akornsys-rdi/simple-inductance-meter/README.md

# Simple Inductance Meter

My implementation of the simple inductance meter designed by Danyk [(http://www.danyk.cz/lmetr_en.html)](http://www.danyk.cz/lmetr_en.html).
