akornsys-rdi/simple-inductance-meter/3d/banana-spacer.stl

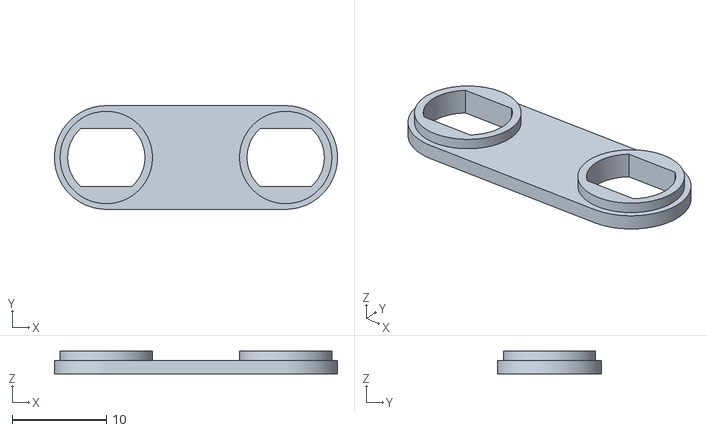
[picture p1: CAD file, 2021-05-23]
3d/banana-spacer.stl
30.1 x 11.0 x 2.40
