akornsys-rdi/simple-inductance-meter/3d/rotary-sw-spacer.stl

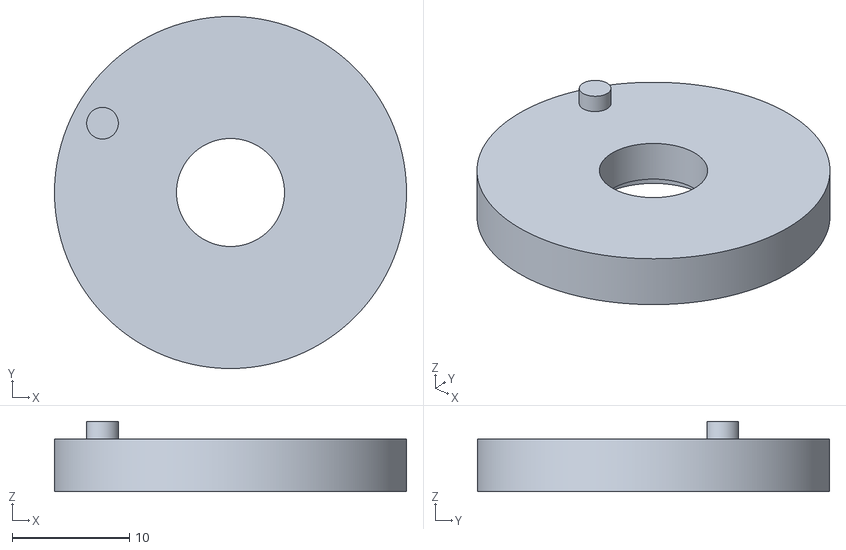
[picture p2: CAD file, 2021-05-23]
3d/rotary-sw-spacer.stl
30.0 x 30.0 x 6.00
