akornsys-rdi/simple-inductance-meter/3d/box.stl

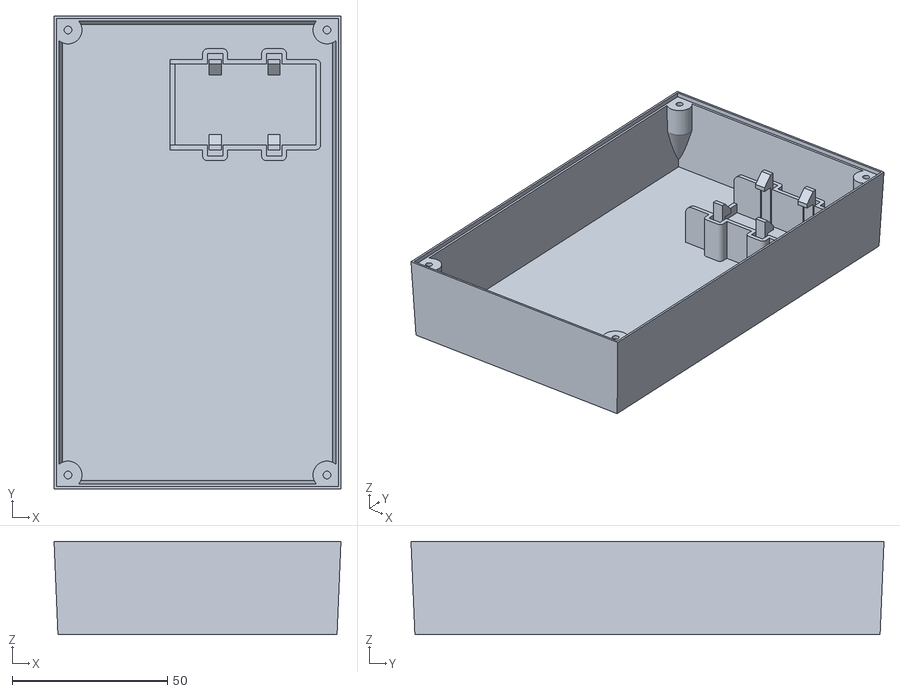
[picture p3: CAD file, 2021-05-23]
3d/box.stl
92.5 x 152.5 x 30.0
