akornsys-rdi/simple-inductance-meter/doc/silkscreen.pdf

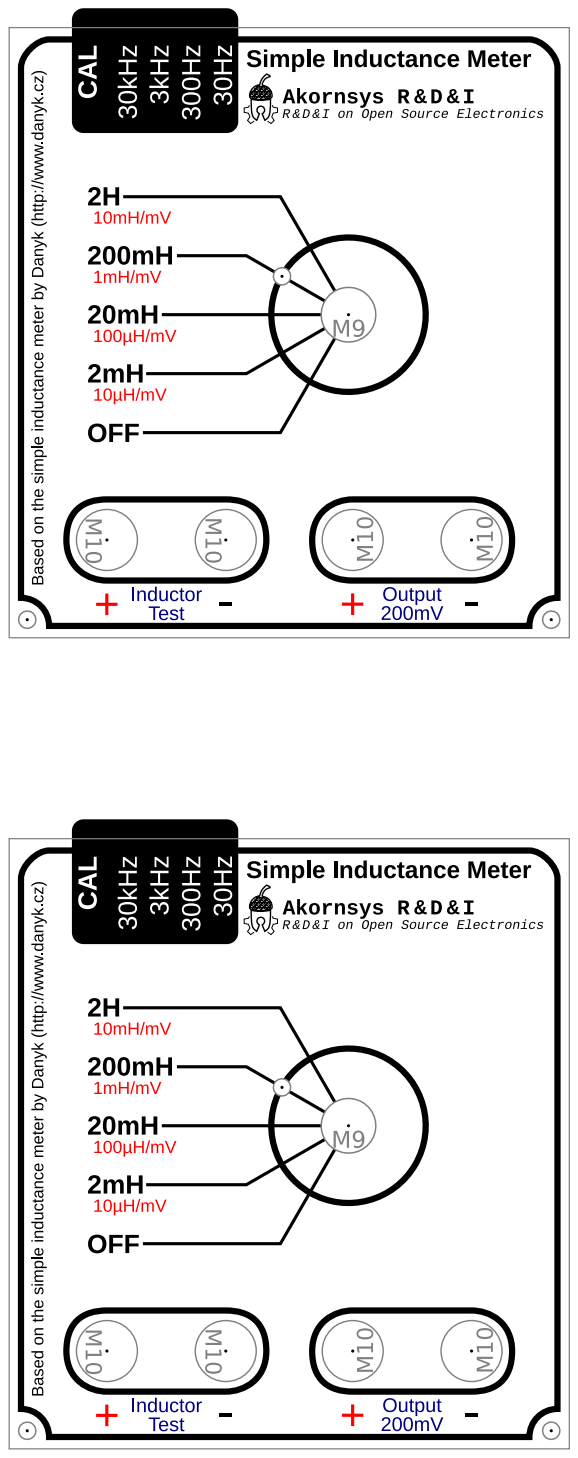
[picture p4: page 1]
