akornsys-rdi/simple-inductance-meter/brd/simple-inductance-meter.kicad_pcb

## KiCad design brd/simple-inductance-meter.kicad_pcb (2021-05-23)

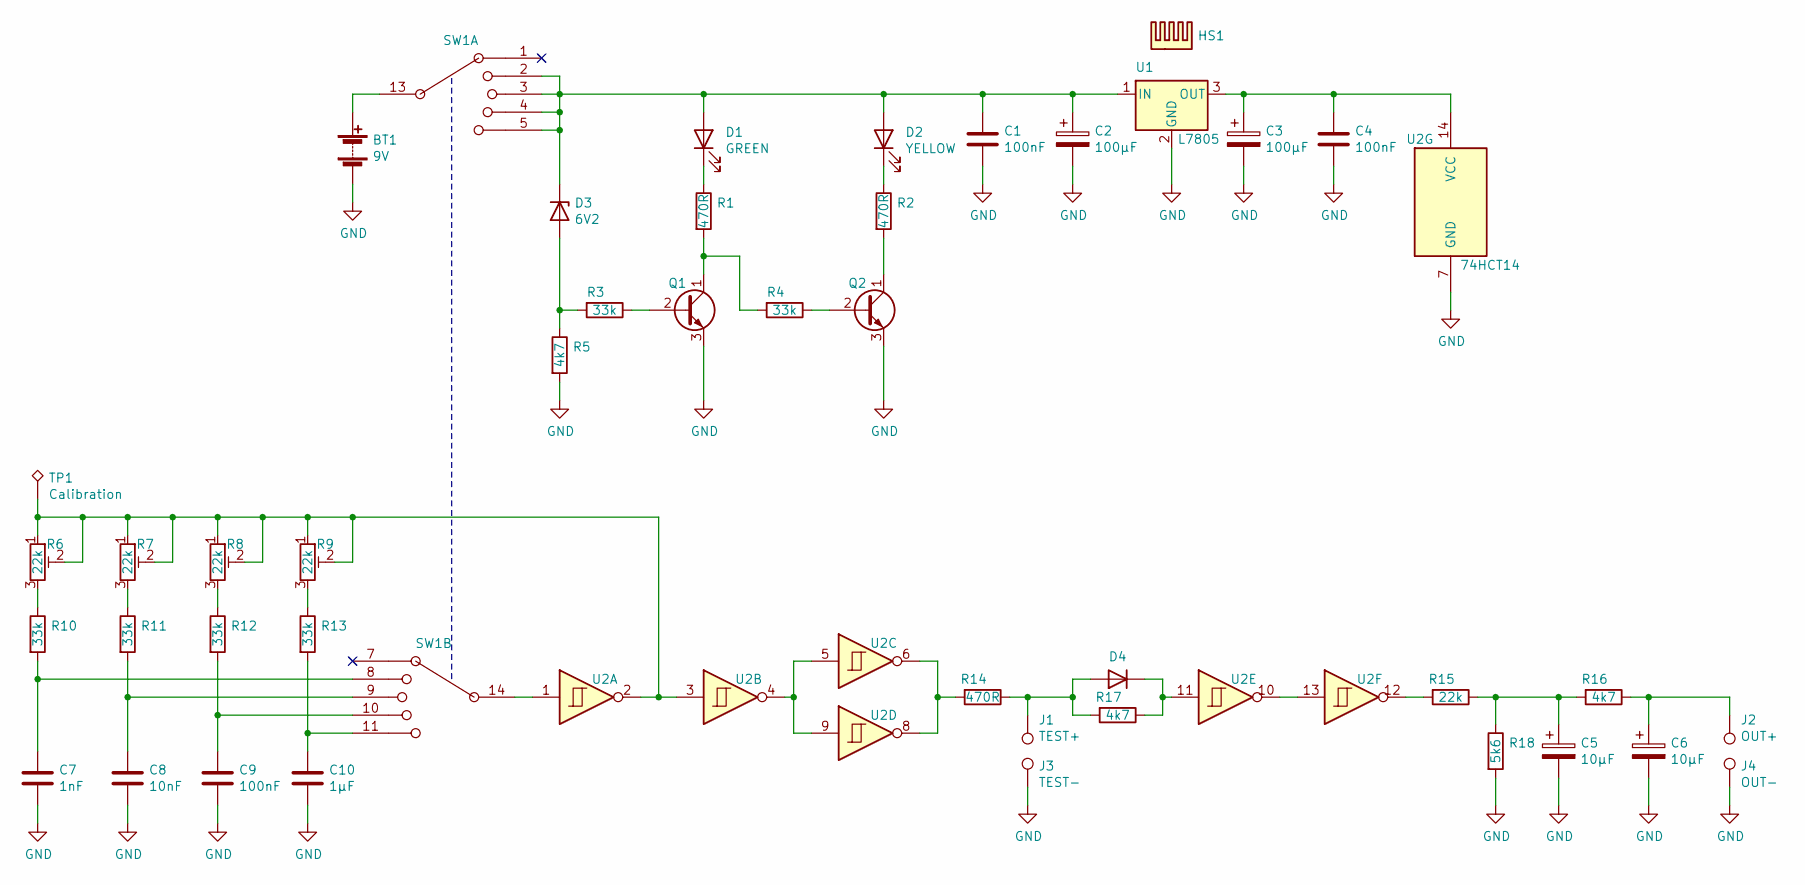
[picture p5: schematic simple-inductance-meter.sch]

Parts:
BT1: 9V; SolderWire-0.5sqmm_1x02_P4.6mm_D0.9mm_OD2.1mm; Manufacturer Part Number 233
C1, C4, C9: 100nF; C_Disc_D4.7mm_W2.5mm_P5.00mm; Manufacturer Part Number K104K15X7RF53H5
C2, C3: 100µF; CP_Radial_D6.3mm_P2.50mm; Manufacturer Part Number 860010473007
C5, C6: 10µF; CP_Radial_Tantal_D5.0mm_P5.00mm; Manufacturer Part Number TAP106K016CRW
C7: 1nF; C_Disc_D4.7mm_W2.5mm_P5.00mm; Manufacturer Part Number K102K15X7RH5UH5
C8: 10nF; C_Disc_D4.7mm_W2.5mm_P5.00mm; Manufacturer Part Number 1C20X7R103K100B
C10: 1µF; C_Disc_D4.7mm_W2.5mm_P5.00mm; Manufacturer Part Number FG28X5R1H105KRT00
D1: GREEN; LED_D5.0mm; Manufacturer Part Number LTL-4233
D2: YELLOW; LED_D5.0mm; Manufacturer Part Number LTL-4273
D3: 6V2; D_DO-41_SOD81_P10.16mm_Horizontal; Manufacturer Part Number BZX85C6V2-TAP
D4: 1N4148; D_DO-35_SOD27_P7.62mm_Horizontal; Manufacturer Part Number 1N4148TR
HS1: TO220 Heatsink; Heatsink_Aavid-TV5G_TO220_Horizontal; Manufacturer Part Number 577002B00000G
J1: TEST+; Banana_Jack_1Pin; Manufacturer Part Number 164-R109R-EX
J2: OUT+; Banana_Jack_1Pin; Manufacturer Part Number 164-R109R-EX
J3: TEST-; Banana_Jack_1Pin; Manufacturer Part Number 164-R109B-EX
J4: OUT-; Banana_Jack_1Pin; Manufacturer Part Number 164-R109B-EX
Q1, Q2: BC547; TO-92_Inline_Wide; Manufacturer Part Number BC547BTA
R1, R2, R14: 470R; R_Axial_DIN0204_L3.6mm_D1.6mm_P2.54mm_Vertical; Manufacturer Part Number MF0204FTE52-470R
R3, R4, R10, R11, R12, R13: 33k; R_Axial_DIN0204_L3.6mm_D1.6mm_P2.54mm_Vertical; Manufacturer Part Number MF0204FTE52-33K
R5, R16, R17: 4k7; R_Axial_DIN0204_L3.6mm_D1.6mm_P2.54mm_Vertical; Manufacturer Part Number MFR25SFRF52-4K7
R6, R7, R8, R9: 22k; Potentiometer_Bourns_3296Y_Vertical; Manufacturer Part Number 3296Y-1-223LF
R15: 22k; R_Axial_DIN0204_L3.6mm_D1.6mm_P2.54mm_Vertical; Manufacturer Part Number MFR-25FTE52-22K
R18: 5k6; R_Axial_DIN0204_L3.6mm_D1.6mm_P2.54mm_Vertical; Manufacturer Part Number MFR-25FTE52-5K6
SW1: SW_Rotary2x5; Manufacturer Part Number SR2511F-0205-19F0B-E9-N-W-159
TP1: Calibration; TestPoint_Loop_D2.50mm_Drill1.0mm
U1: L7805; TO-220-3_Horizontal_TabDown; Manufacturer Part Number L7805ABV
U2: 74HCT14; DIP-14_W7.62mm_LongPads; Manufacturer Part Number SN74HCT14N

Connections:
GND: BT1.2 (-), C1.2, C2.2, C3.2, C4.2, C5.2, C6.2, C7.2, C8.2, C9.2, C10.2, J3.1, J4.1, Q1.3 (E), Q2.3 (E), R5.2, R18.2, U1.2 (GND), U2.7 (GND)
unnamed: BT1.1 (+), SW1.13 (14)
unnamed: C1.1, C2.1, D1.2 (A), D2.2 (A), D3.1 (K), SW1.2, SW1.3, SW1.4, SW1.5, U1.1 (IN)
unnamed: C3.1, C4.1, U1.3 (OUT), U2.14 (VCC)
unnamed: C5.1, R15.1, R16.2, R18.1
unnamed: C6.1, J2.1, R16.1
unnamed: C7.1, R10.2, SW1.8 (2)
unnamed: C8.1, R11.2, SW1.9 (3)
unnamed: C9.1, R12.2, SW1.10 (4)
unnamed: C10.1, R13.2, SW1.11 (5)
unnamed: D1.1 (K), R1.1
unnamed: D2.1 (K), R2.1
unnamed: D3.2 (A), R3.2, R5.1
unnamed: D4.1 (K), R17.1, U2.11
unnamed: D4.2 (A), J1.1, R14.1, R17.2
unnamed: Q1.1 (C), R1.2, R4.2
unnamed: Q1.2 (B), R3.1
unnamed: Q2.1 (C), R2.2
unnamed: Q2.2 (B), R4.1
unnamed: R6.1, R6.2, R7.1, R7.2, R8.1, R8.2, R9.1, R9.2, TP1.1, U2.2, U2.3
unnamed: R6.3, R10.1
unnamed: R7.3, R11.1
unnamed: R8.3, R12.1
unnamed: R9.3, R13.1
unnamed: R14.2, U2.6, U2.8
unnamed: R15.2, U2.12
unnamed: SW1.14, U2.1
unnamed: U2.4, U2.5, U2.9
unnamed: U2.10, U2.13

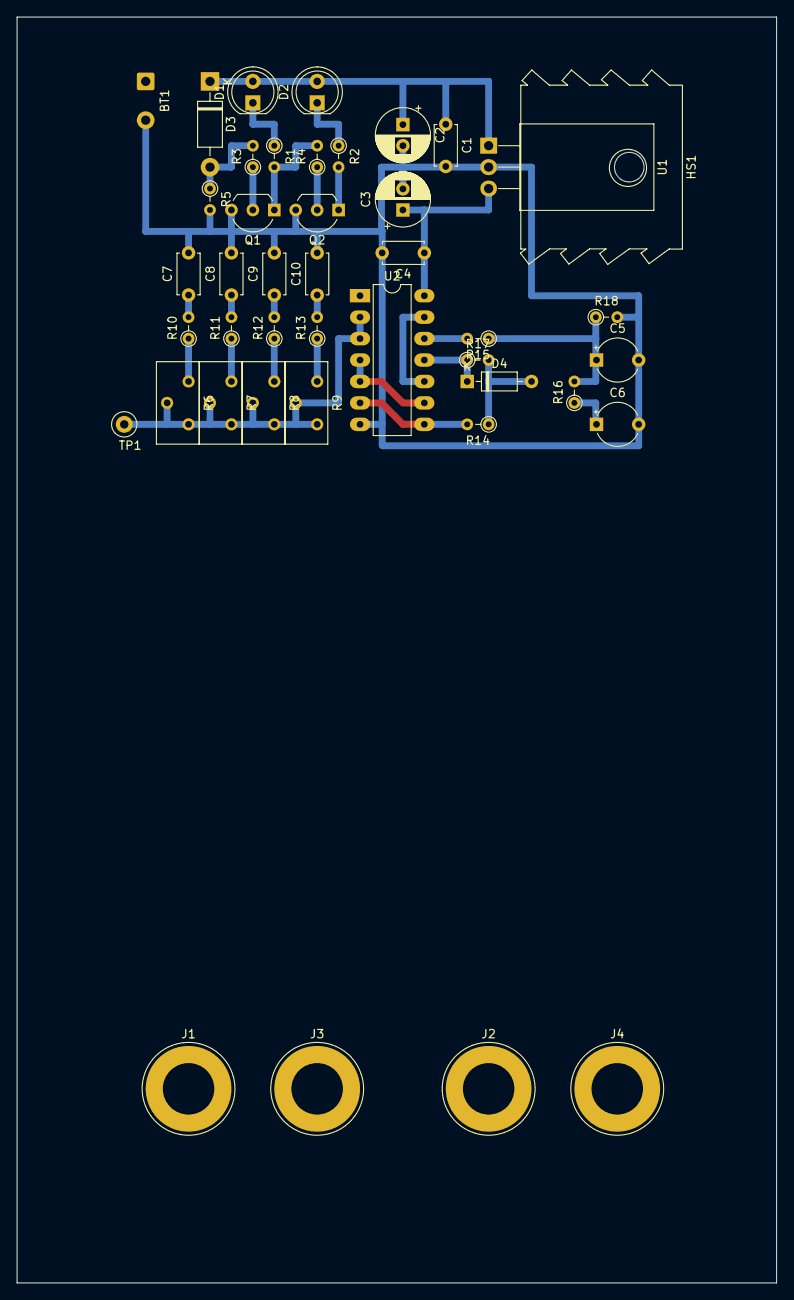
[picture p6: board simple-inductance-meter.kicad_pcb from above]

Board: 2 copper layers, 90.0 x 150.0 mm, 43 parts (0 on the bottom side), 27 nets.
